Kybernetika-SPSE/RP_Svitek/README.md

# RP_Svitek
Model malého letadla na dálkové ovládání se zaměřením na aerodynamiku.
