Kybernetika-SPSE/RP_Svitek/součástky/list.md

# **Seznam součástek**
seznam součástek potřebných k provozu
## ovladač
- HC-12
- ESP32
- Joysticky ze starého ovladače
## letadlo
- ESP32
- HC-12
- **[lepší letadlový motor](https://www.houska-modelar.cz/shop/product_info.php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)**
- [Serva](https://www.laskakit.cz/mini-servo-mg90s-s-kovovymi-prevody/)
- napájení
  -  **[baterie 1](https://www.rcprofi.cz/kavan-li-po-1300mah-11-1v-40-80c-14-4wh)** 
- [ESC ](https://www.bighobby.cz/regulator-otacek-40a-hornet--2-4s-/)
- [vrtule](https://www.rcprofi.cz/apc-vrtule-8x4-pravotociva)

## doplňky
- [LiPo nabioječka](https://www.laskakit.cz/imax-b3-20w-nabijecka-1-6a-pro-2s-3s-lipo-baterie/)
- [multimetr](https://www.laskakit.cz/aneng-dm850-digitalni-multimetr/)
