Kybernetika-SPSE/RP_Svitek/zapojení/zapojení LETADLO.md

## Zapojení letadla
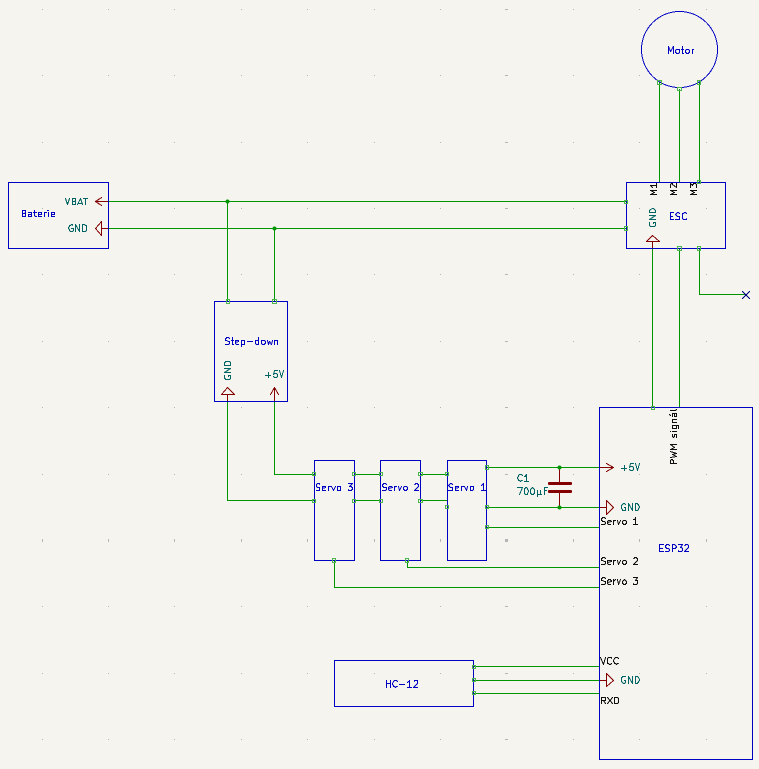
[picture p1: zapojení/jednoduché schéma.png]


Jednoduché zapojení elektroniky v letadle, [baterie](https://www.rcprofi.cz/kavan-li-po-1300mah-11-1v-40-80c-14-4wh) dodává zhruba 11V a maximálně až 106A do [ESC](https://www.bighobby.cz/regulator-otacek-40a-hornet--2-4s-/), který vytvoří trojfázový AC pro napájení [motoru](https://www.houska-modelar.cz/shop/product_info.php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) který bere okolo 20-25A což baterie dokáže poskytnout bez problémů. 

Kondenzátor slouží k potlačení napěťových špiček a stabilizaci 5V zdroje. Timto bude ESP napájeno stabilně a step-down zvládne zátěž až 5A což je víc než dost. Přes ESP pak budeme ovládat skrze ESC Throttle motoru.

Tenhle ESC má vlastní zdroj "BEC" který má limit 3A což bude stačit pro Serva + ESP. 3x Serva.
