Kybernetika-SPSE/RP_Svitek/součástky/Motor.md

# **Motor a vrtule**
## Motor 1
Po menším skenování online obchodů a diskuzi s Ai jsem si vybral motor **[MT2204](https://www.hadex.cz/l741-motor-stridavy-mt2204-pro-drony-pravotocivy/?gad_source=1&gad_campaignid=17347780553)**, který **váží pouze 25g** a jeho maximální tah se správnou vrtulí a baterií je 440g což snad mude stačit pro můj model u kterého čekám hmotnost tak 150-200g. Tah by měl být alespoň 2x váha aby letadlo mohlo vzlétnout. Pokud model bude těžší tak hodu dát na každé křídlo jeden motor jako u komerčních cestovních letadel. Motor bude potřenovat napětí alespoň 7,4V a ideálně okolo **11V a 5,5A**.

## Motor 2
jelikož motor 1 je určen pro drony tak má více otáček což znamená že je účinější s menšími vrtulemi, dalíš mototr co sem vybral je [KAVAN Brushless motor C2822-1400](https://www.houska-modelar.cz/shop/product_info.php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), je to přímo motor pro RC letadla takže má větší tah při nižších otáčkách a je tišší. Tohle je asi **lepší volba**.

## Vrtule
V technické specifikaci je doporučená pro motor [MT2204](https://www.hadex.cz/l741-motor-stridavy-mt2204-pro-drony-pravotocivy/?gad_source=1&gad_campaignid=17347780553) vrtule velikosti 5"-6". Takových vrtulí je všude na internetu dost jedno balení co se mi líbilo je **[6x4E Bi Blade Propeller Pack of 5](https://www.unmannedtechshop.co.uk/products/6x4e-bi-blade-propeller-pack-of-5-hee-wing-f-01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)** tohle je dost levné a snad 5 vrtulí bude stačit.

pro mototr **KAVAN Brushless motor C2822-1400** jsou vrtule větší takže něco jako tato [vrtule](https://www.rcprofi.cz/apc-vrtule-8x6-pravotociva#description)
