Kybernetika-SPSE/RP_Svitek/dokumentace/Cm graf.png

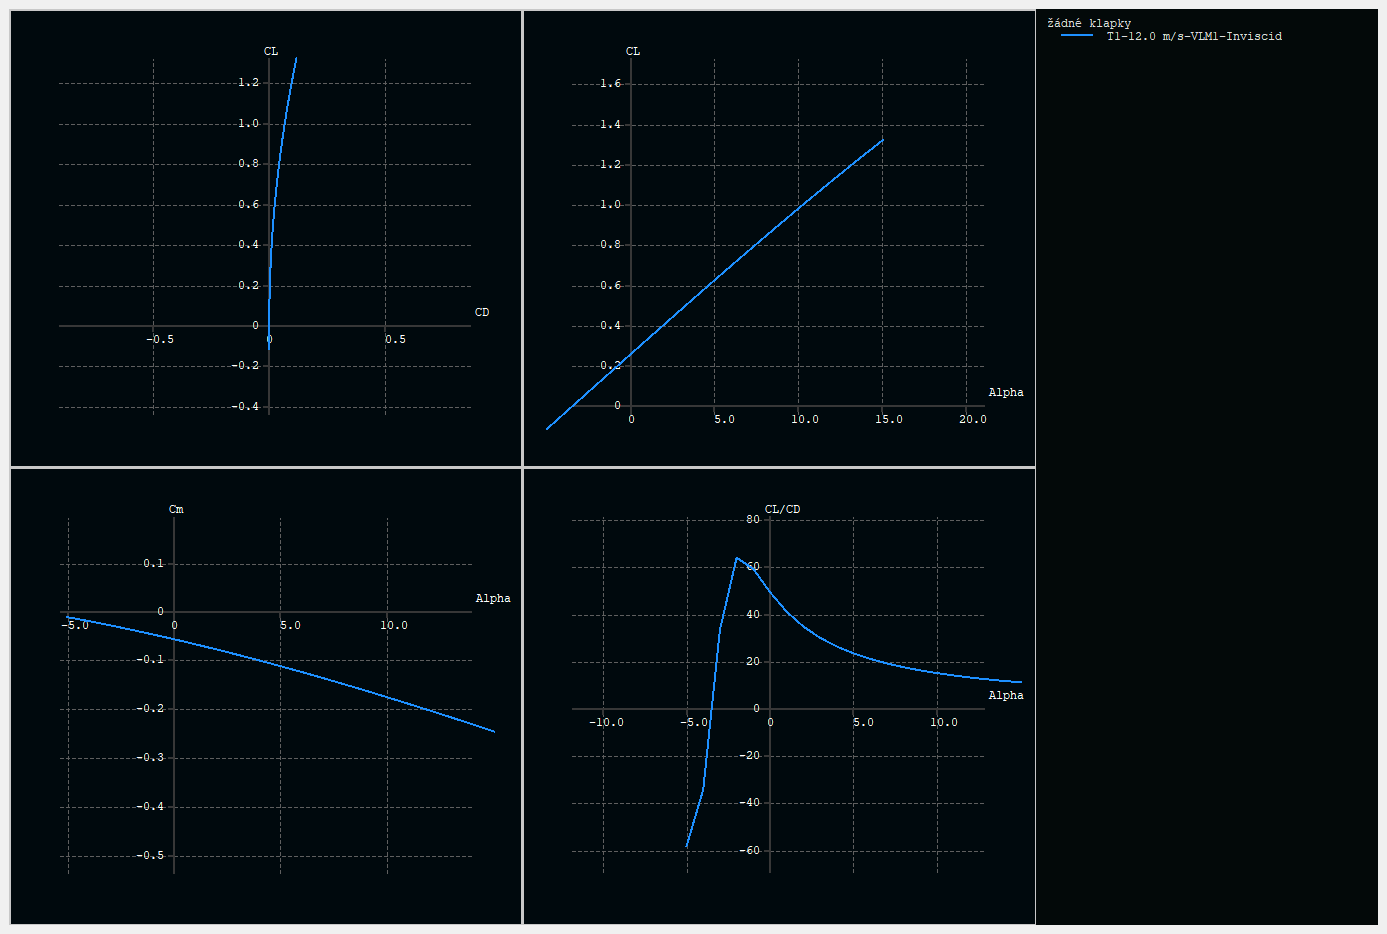
dokumentace/Cm graf.png
