Kybernetika-SPSE/RP_Svitek/dokumentace/IMG_2235.jpg

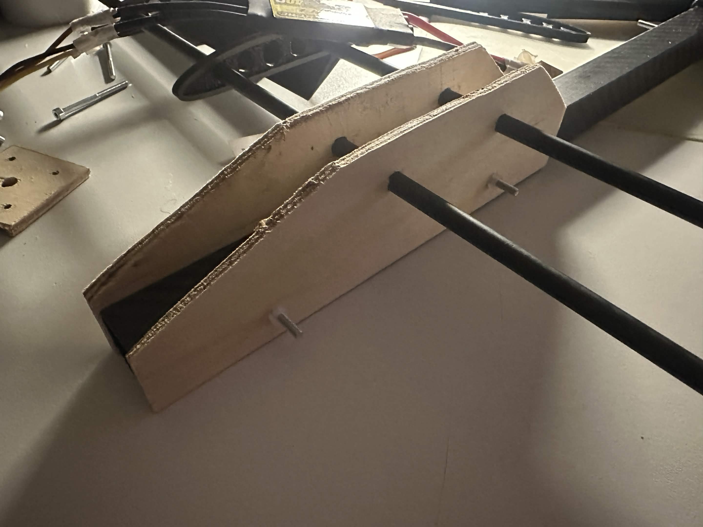
dokumentace/IMG_2235.jpg
