Kybernetika-SPSE/RP_Svitek/dokumentace/rozlozeni_tlaku.png

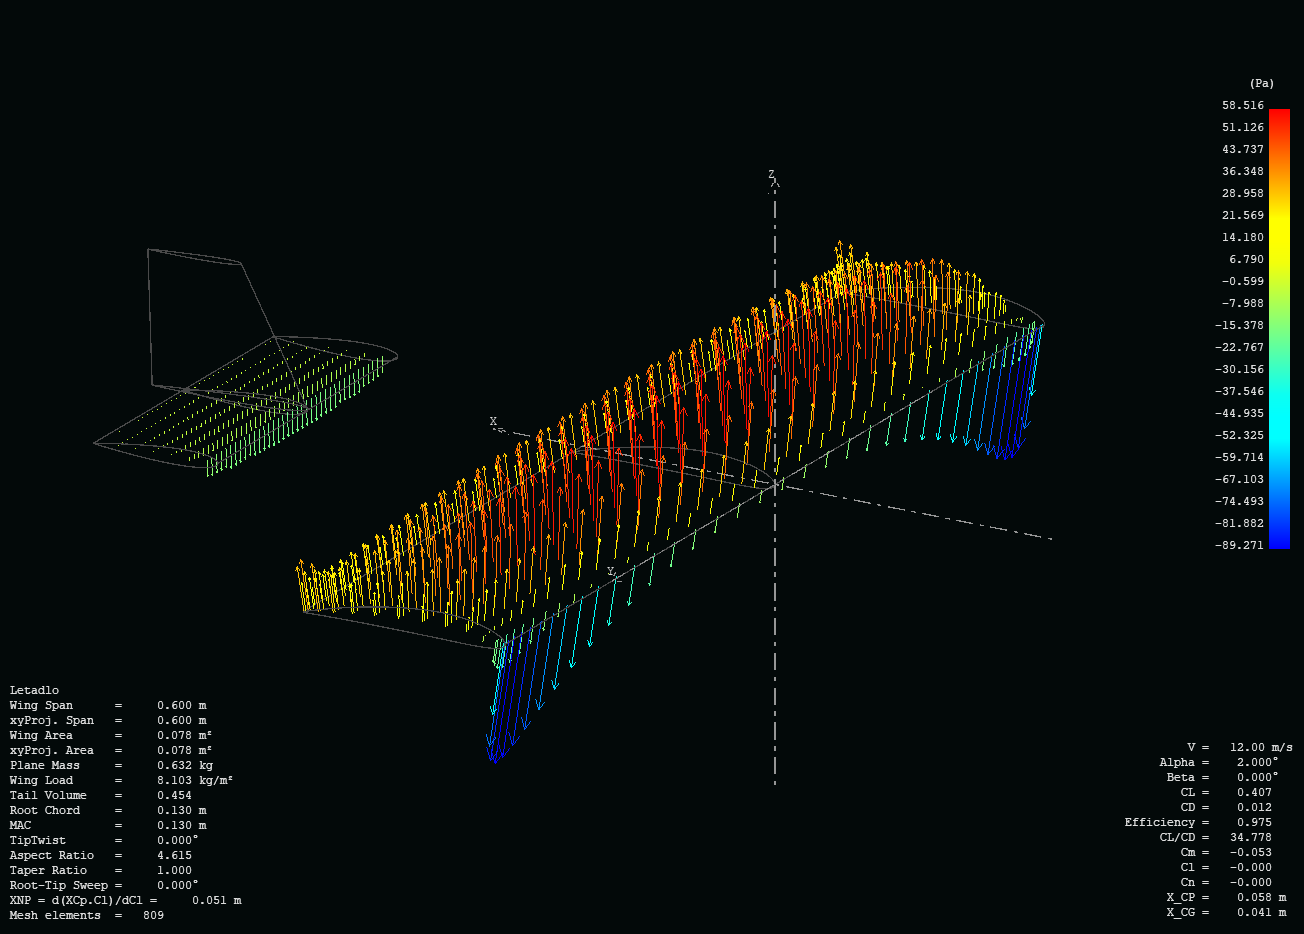
dokumentace/rozlozeni_tlaku.png
