Kybernetika-SPSE/RP_Svitek/(list of files, cad)

Other CAD files:
3d model/výkresy/SERVO držák.dwg
3d model/výkresy/vertical_stab.dwg
3d model/výkresy/Aileronn.dwg
3d model/výkresy/horizontal_stab.dwg
3d model/výkresy/Profil NACA 4412.dwg
3d model/výkresy/horizontal_stab_elevator.dwg
3d model/výkresy/OldVersions/SERVO držák.0009.dwg
3d model/výkresy/OldVersions/vertical_stab.0007.dwg
3d model/výkresy/OldVersions/horizontal_stab.0004.dwg
3d model/výkresy/OldVersions/Aileronn.0001.dwg
3d model/výkresy/OldVersions/Profil NACA 4412.0009.dwg
3d model/OldVersions/Profil NACA 4412 2.0011.ipt
3d model/OldVersions/Profil NACA 4412 NOFLAPS.0001.ipt
3d model/OldVersions/Profil NACA 4412.0008.ipt
3d model/OldVersions/Sestava1.0005.iam
3d model/OldVersions/pokus 1 .0004.ipt
3d model/OldVersions/pokus 1 flap 4412 .0004.ipt
3d model/Profil NACA 4412 NOFLAPS.ipt
3d model/Profil NACA 4412.ipt
3d model/Sestava1.iam
3d model/lepší/AS 1110 - M5 x 25.ipt
3d model/lepší/Aileronn.ipt
3d model/lepší/Hlavni_pater.ipt
3d model/lepší/NOAileron.ipt
3d model/lepší/NOAileronSERVO.ipt
3d model/lepší/OldVersions/Aileronn.0006.ipt
3d model/lepší/OldVersions/Hlavni_pater.0009.ipt
3d model/lepší/OldVersions/NOAileron.0005.ipt
3d model/lepší/OldVersions/NOAileronSERVO.0001.ipt
3d model/lepší/OldVersions/NOailer.0001.ipt
3d model/lepší/OldVersions/Profil NACA 0012.0004.ipt
3d model/lepší/OldVersions/Profil NACA 4412 2.0013.ipt
3d model/lepší/OldVersions/Profil.0006.ipt
3d model/lepší/OldVersions/SERVO držák.0011.ipt
3d model/lepší/OldVersions/Servo.0005.ipt
3d model/lepší/OldVersions/Sestava.0079.iam
3d model/lepší/OldVersions/Sestava_mark1.0002.iam
3d model/lepší/OldVersions/Trup.0006.ipt
3d model/lepší/OldVersions/horizontal_stab.0021.ipt
3d model/lepší/OldVersions/horizontal_stab_elevator.0008.ipt
3d model/lepší/OldVersions/motor držák.0001.ipt
3d model/lepší/OldVersions/trojúhleník.0015.ipt
3d model/lepší/OldVersions/trojúhleník_FF.0002.ipt
3d model/lepší/OldVersions/trojúhleník_closer.0003.ipt
3d model/lepší/OldVersions/táhlo.0001.ipt
3d model/lepší/OldVersions/tělo_pokus2.0006.ipt
3d model/lepší/OldVersions/vertical_stab.0012.ipt
3d model/lepší/OldVersions/vetrovaniig.0004.ipt
3d model/lepší/Profil NACA 0012.ipt
3d model/lepší/Profil NACA 4412 2.ipt
3d model/lepší/Profil.ipt
3d model/lepší/SERVO držák.ipt
3d model/lepší/Servo.ipt
3d model/lepší/Sestava.iam
3d model/lepší/Sestava_mark1.iam
3d model/lepší/Sestava_mark2.iam
3d model/lepší/Trup.ipt
3d model/lepší/Těl_tyč.ipt
3d model/lepší/drzakmotoru_nový.ipt
3d model/lepší/horizontal_stab.ipt
3d model/lepší/horizontal_stab_elevator.ipt
3d model/lepší/motor držák.ipt
3d model/lepší/trojúhleník.ipt
3d model/lepší/trojúhleník_FF.ipt
3d model/lepší/tyč.ipt
3d model/lepší/táhlo.ipt
3d model/lepší/tělo_pokus2.ipt
3d model/lepší/vertical_stab.ipt
3d model/lepší/vetrovaniig.ipt
3d model/pokus 1 .ipt
3d model/pokus 1 flap 4412 .ipt
3d model/tyč.ipt
3d model/výkresy/Hlavni_pater.idw
3d model/výkresy/OldVersions/Hlavni_pater.0004.idw
3d model/výkresy/OldVersions/Trup.0006.idw
3d model/výkresy/Trup.idw
3d model/výkresy/Uchytka_motoru.idw
