Kybernetika-SPSE/RP_Svitek/Software/TESTY/HC-12 RXTX test/test_LEDky_a _joystick_HC-12/přijímač.jpg

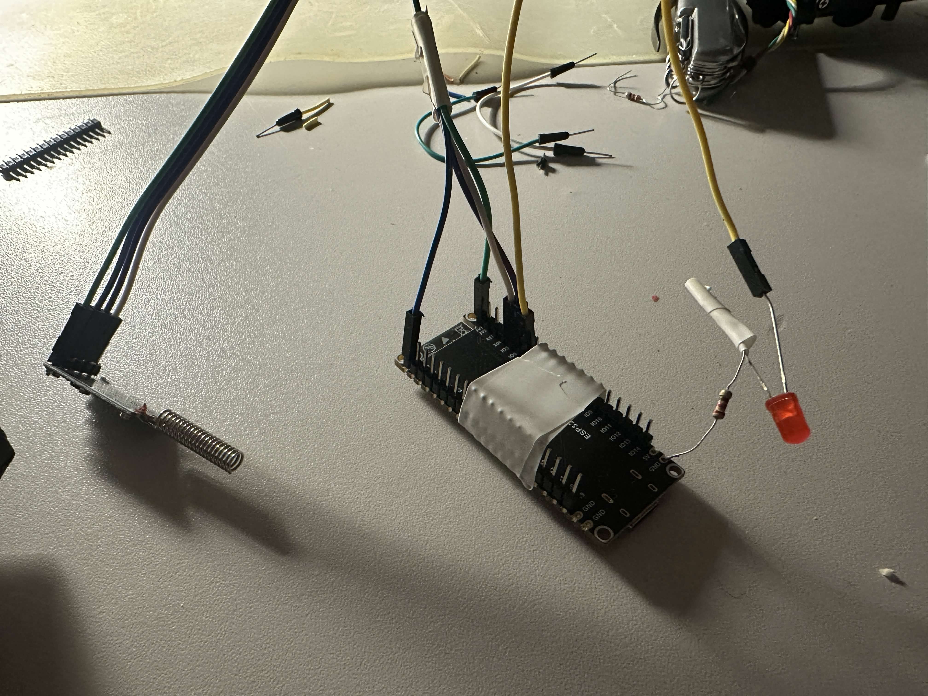
Software/TESTY/HC-12 RXTX test/test_LEDky_a _joystick_HC-12/přijímač.jpg
