Kybernetika-SPSE/RP_Svitek/XFLR/TEST/sim a = 5°/ailerons DOWN.png

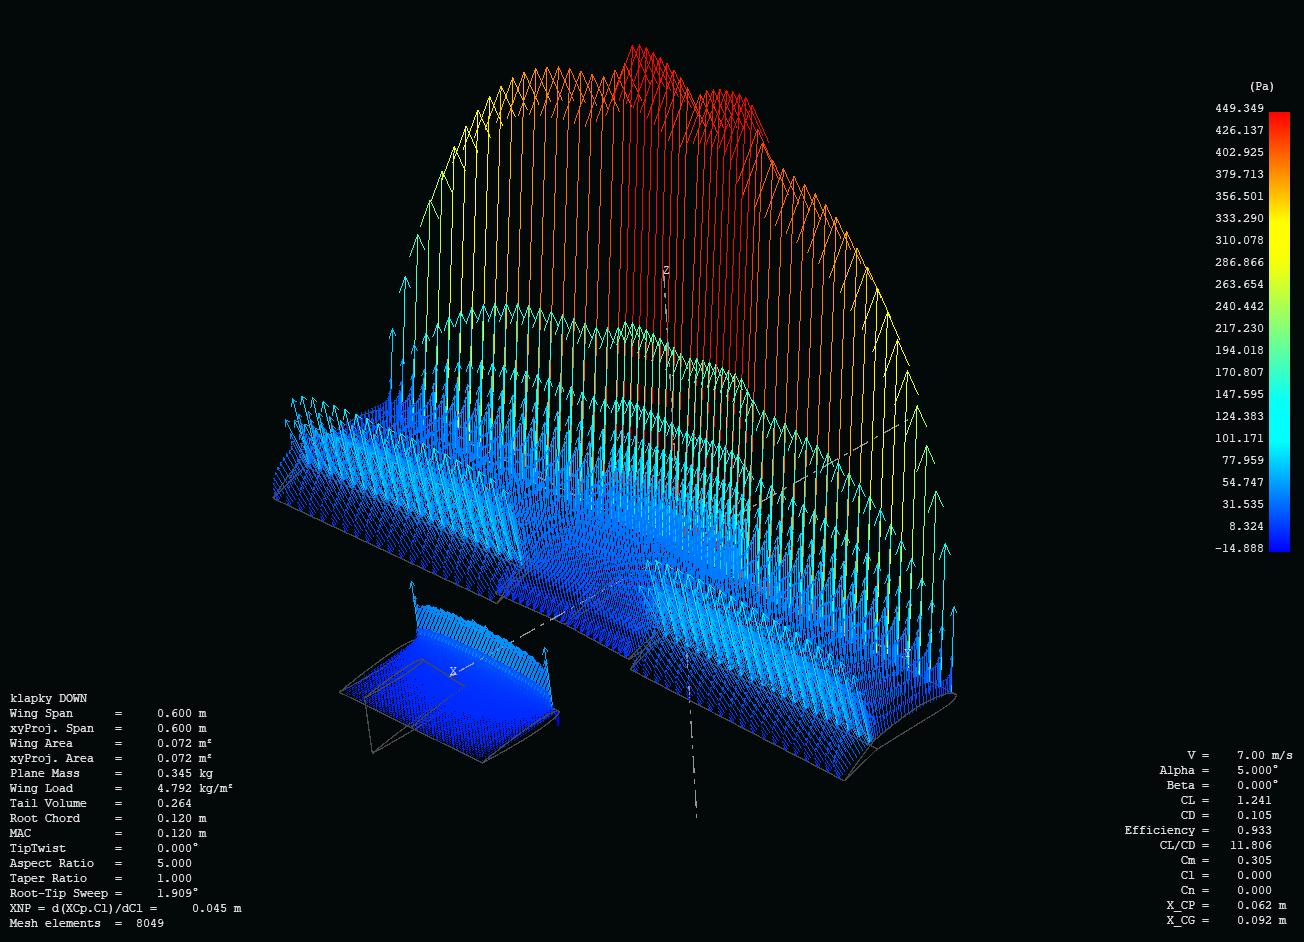
XFLR/TEST/sim a = 5°/ailerons DOWN.png
