Kybernetika-SPSE/RP_Svitek/XFLR/TEST/sim a = 5°/ailerons UP.png

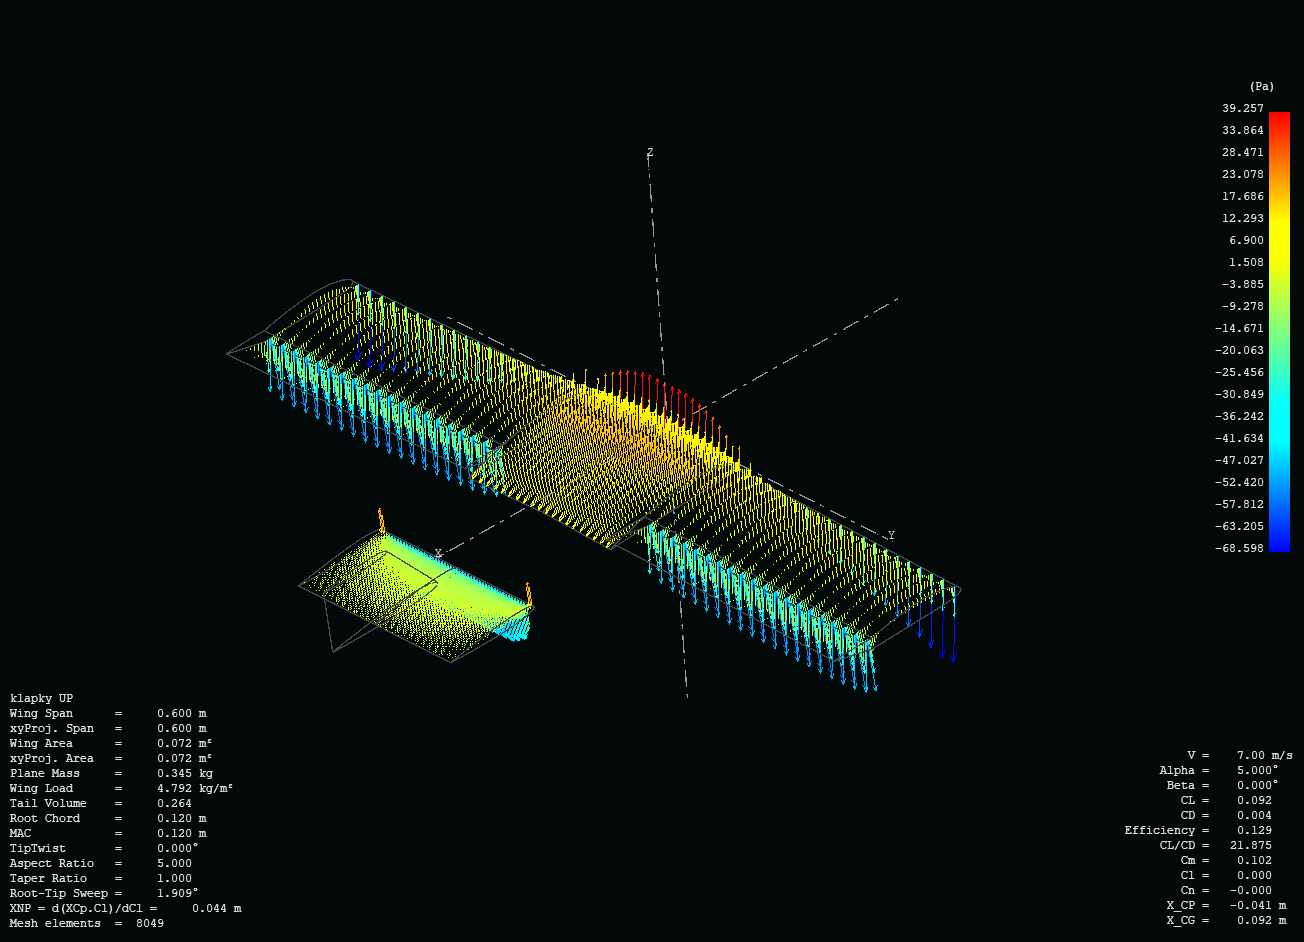
XFLR/TEST/sim a = 5°/ailerons UP.png
