Kybernetika-SPSE/RP_Svitek/XFLR/TEST/sim a = 5°/CL graf profil 4412.png

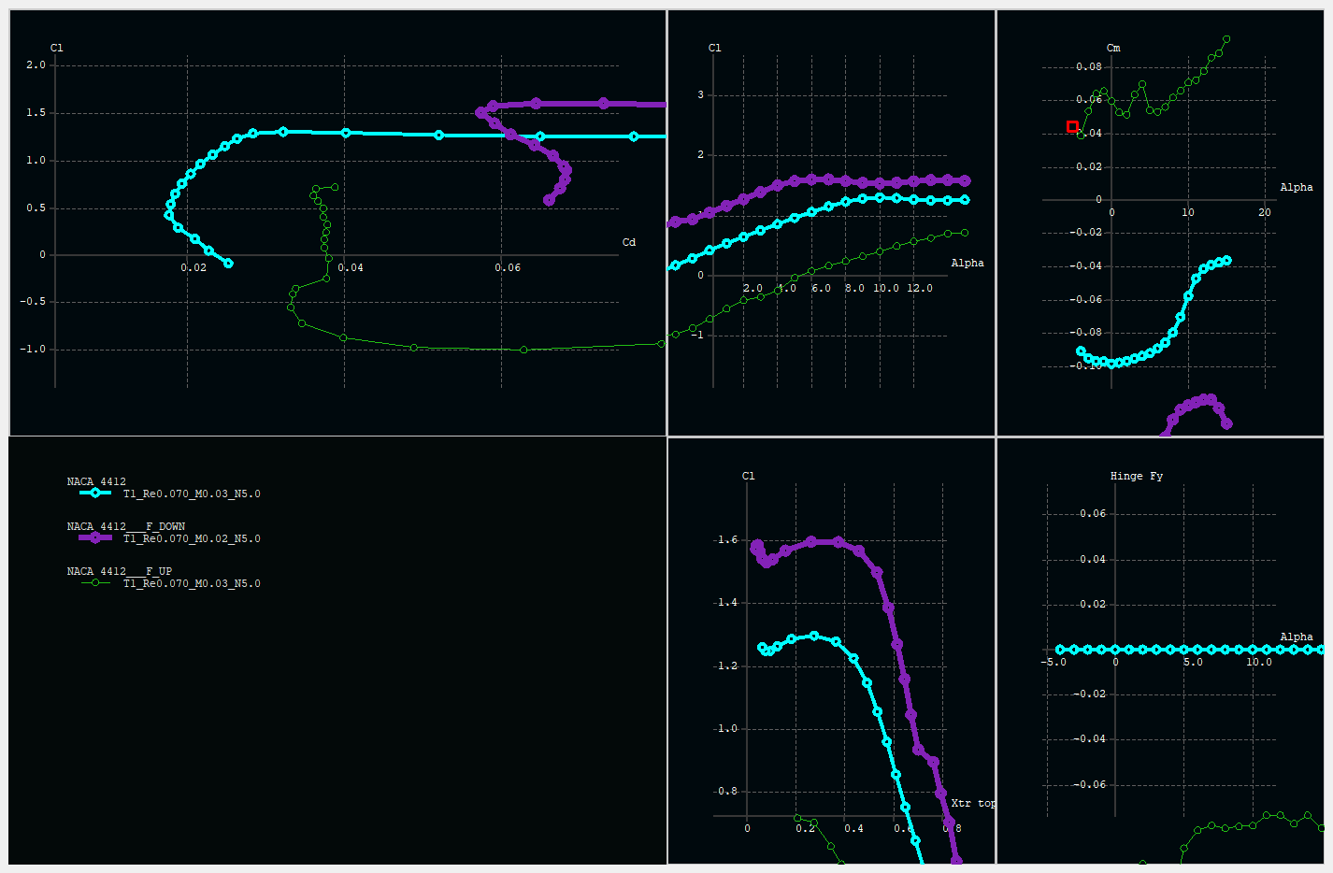
XFLR/TEST/sim a = 5°/CL graf profil 4412.png
