Kybernetika-SPSE/RP_Svitek/XFLR/TEST/sim a = 5°/CL graf.png

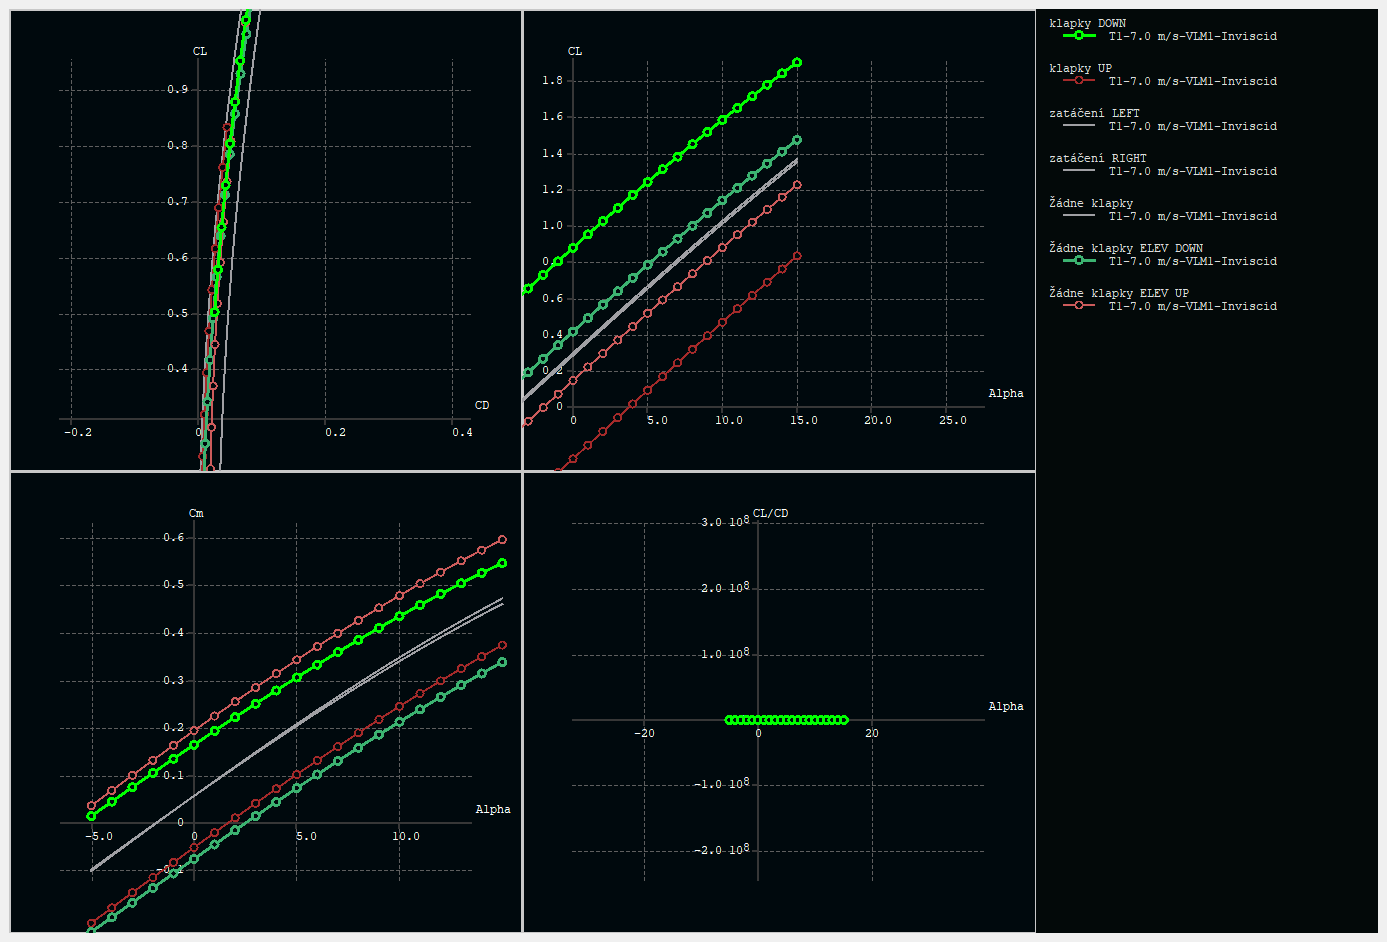
XFLR/TEST/sim a = 5°/CL graf.png
