Kybernetika-SPSE/RP_Svitek/XFLR/TEST/sim a = 5°/rozložení tíhy.png

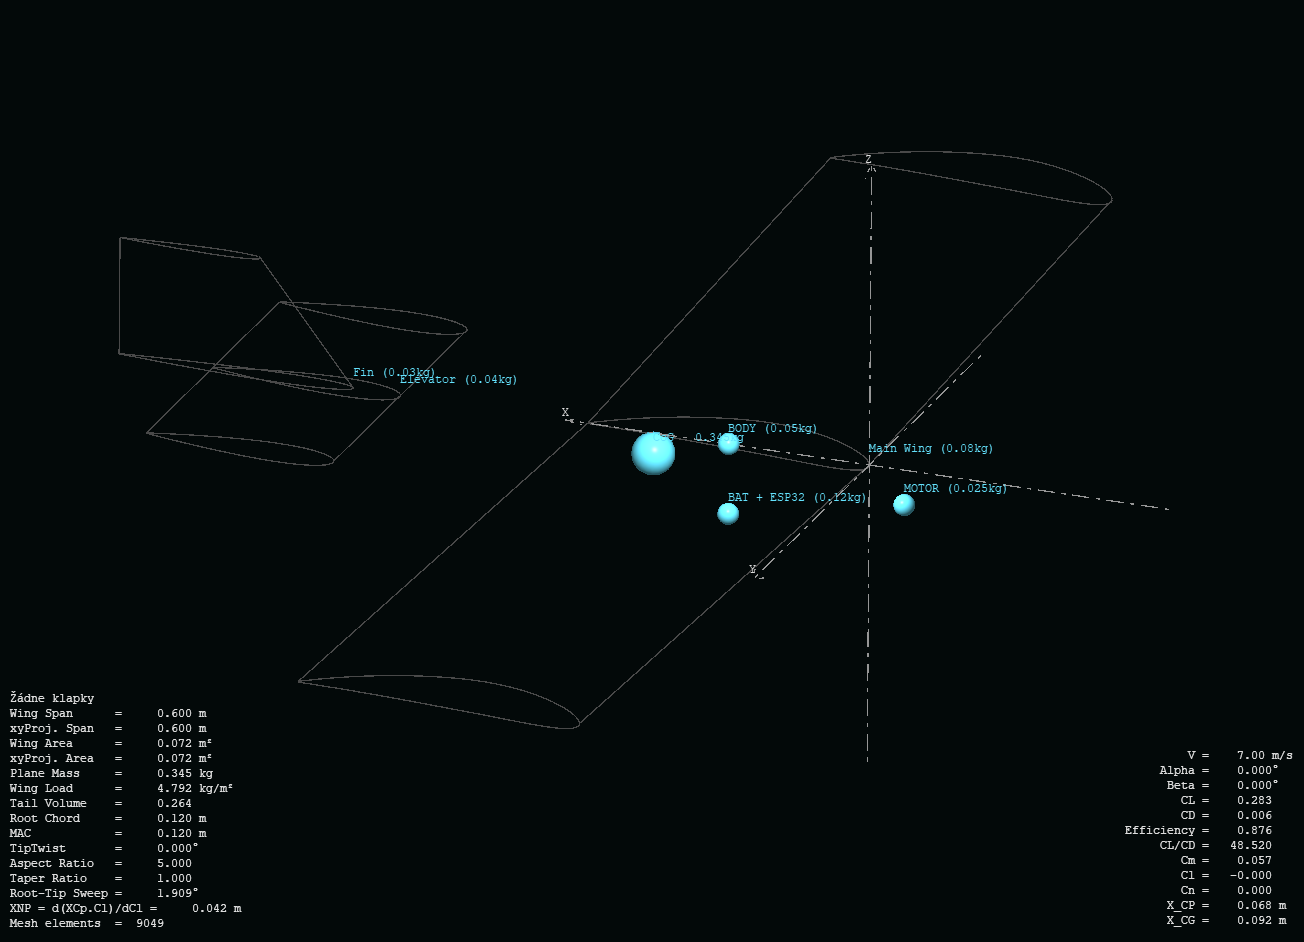
XFLR/TEST/sim a = 5°/rozložení tíhy.png
