Kybernetika-SPSE/RP_Svitek/XFLR/TEST/sim a = 5°/zatáčení LEFT.png

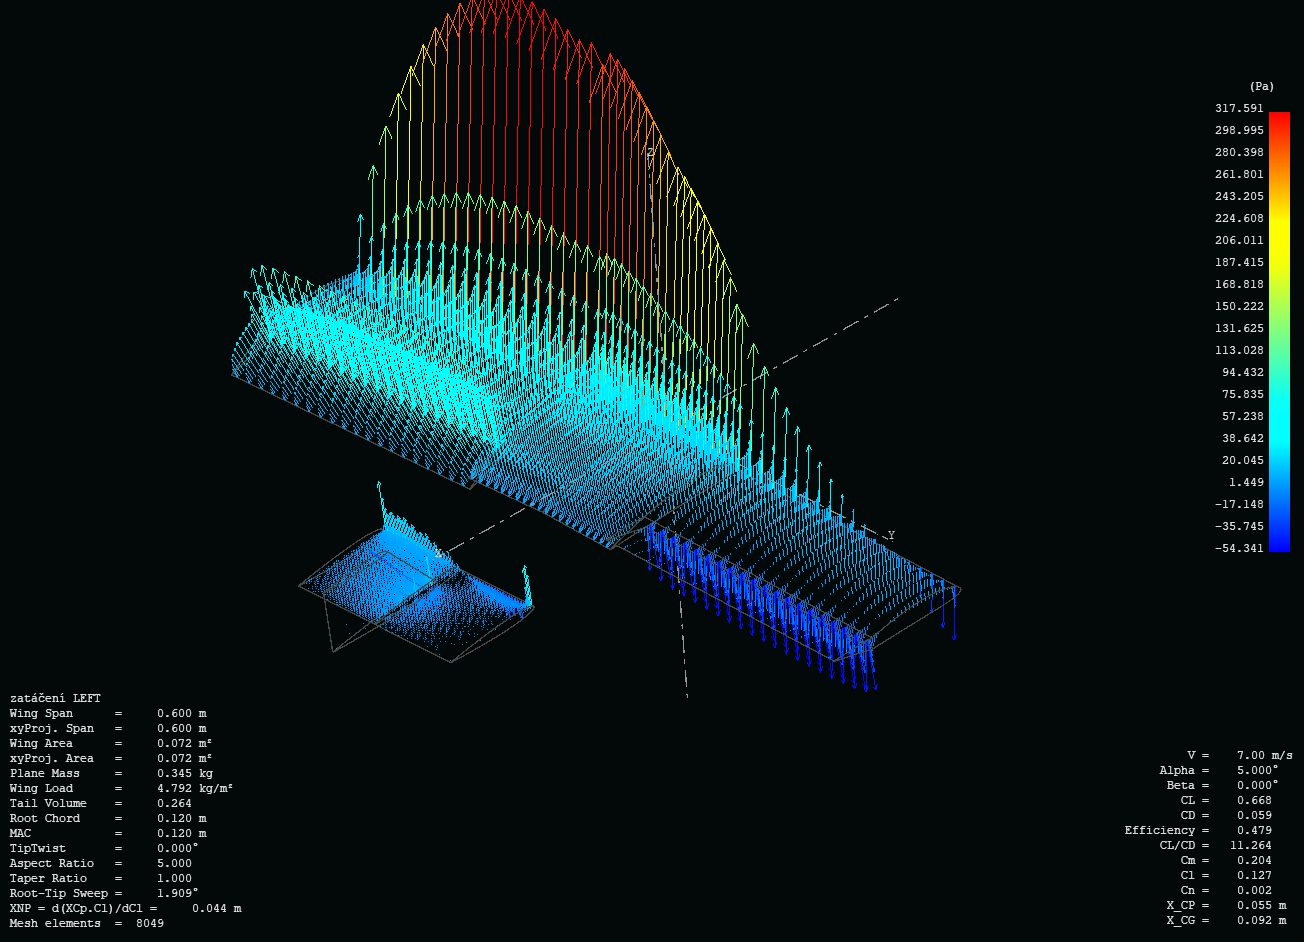
XFLR/TEST/sim a = 5°/zatáčení LEFT.png
