Kybernetika-SPSE/RP_Svitek/XFLR/TEST/sim a = 5°/zatáčení RIGHT.png

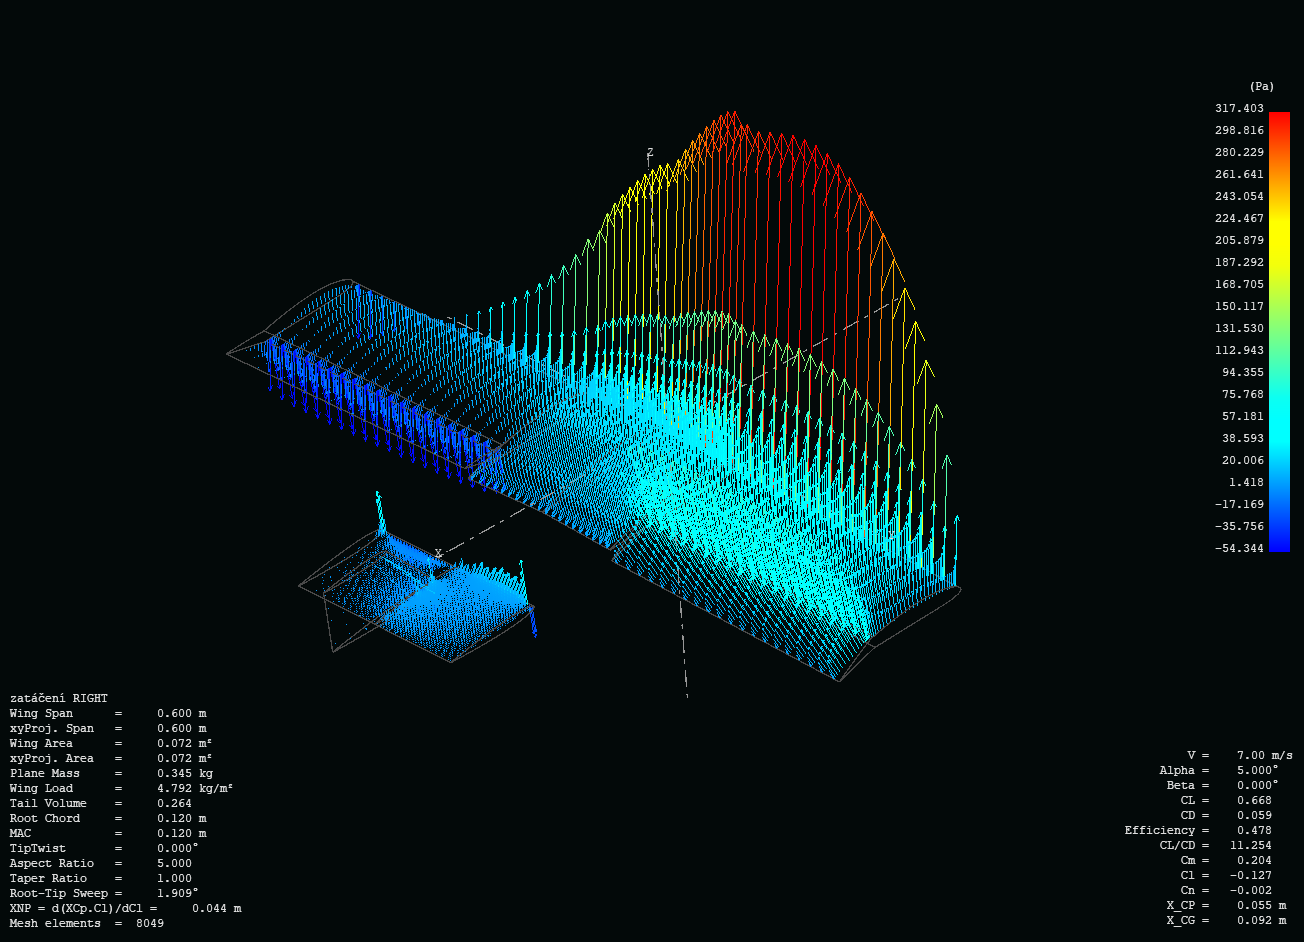
XFLR/TEST/sim a = 5°/zatáčení RIGHT.png
