Kybernetika-SPSE/RP_Svitek/XFLR/TEST/sim a = 5°/Žádné klapky ELEV DOWN.png

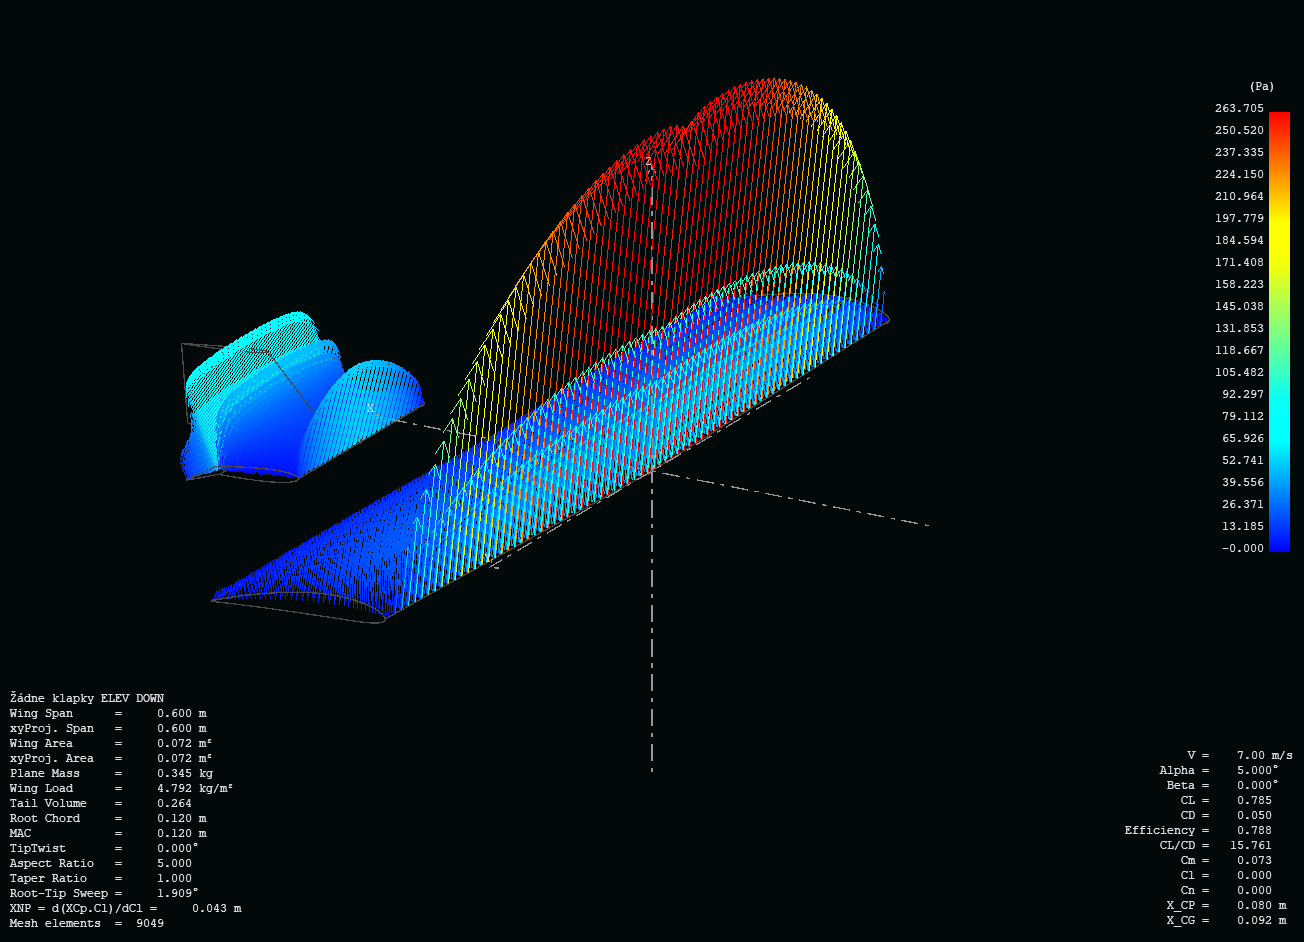
XFLR/TEST/sim a = 5°/Žádné klapky ELEV DOWN.png
