Kybernetika-SPSE/RP_Svitek/XFLR/TEST/sim a = 5°/Žádné klapky ELEV UP.png

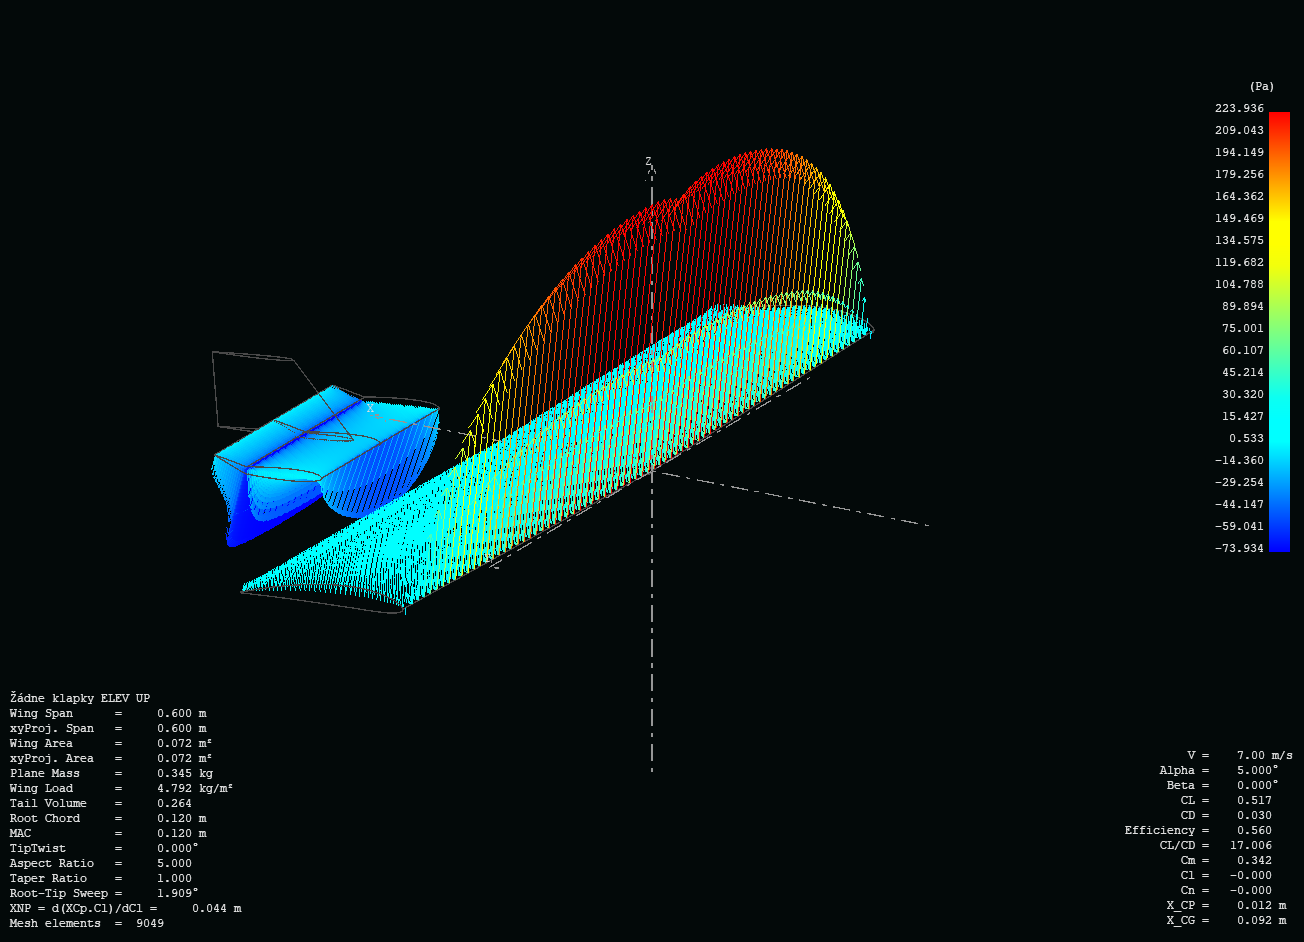
XFLR/TEST/sim a = 5°/Žádné klapky ELEV UP.png
