Kybernetika-SPSE/RP_Svitek/3d model/výkresy/Dřevěná příložka.pdf

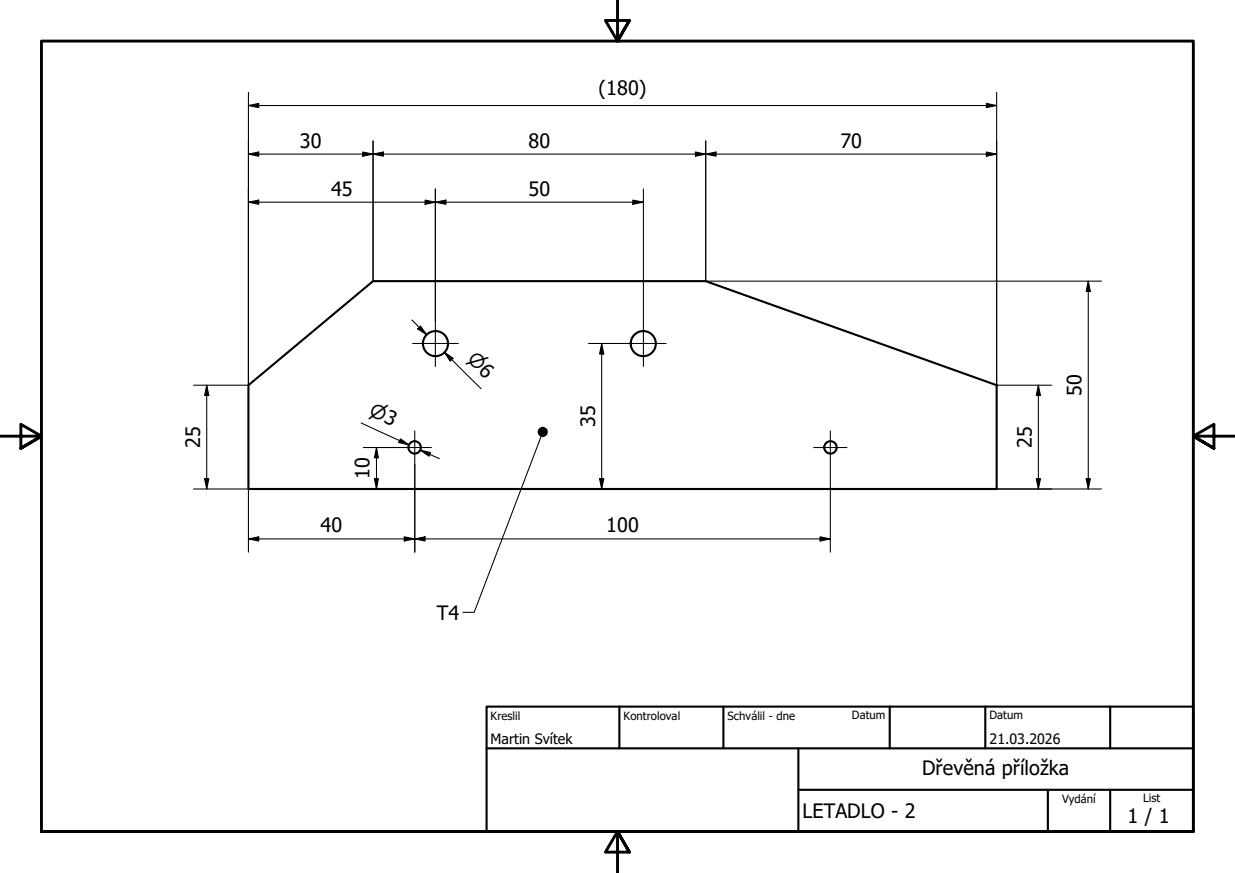
[picture p32: page 1]

Kreslil Martin Svítek | Kontroloval | Schválil - dne Datum | Datum 21.03.2026

Dřevěná příložka

LETADLO - 2 | Vydání | List 1 / 1
