Kybernetika-SPSE/RP_Svitek/(commit log)

2025-12-04 motory a vrtle + fixs
2025-12-05 změny provedené v dokumentaci motorů.
2026-01-05 fix
    Updated the table to include area values for each wing component and added a section on tail volume coefficient.
2026-01-05 hc-12 update
    Replaced 'ESP32 heltec V4' with 'HC-12' in the components list.
2026-01-17 lepší seznam součástek
    [Sestava1.0003.iam, Sestava1.iam, pokus 1 .0002.ipt, pokus 1 .0004.ipt, pokus 1 .ipt, pokus 1 flap 4412 .0004.ipt, pokus 1 flap 4412 .ipt, tyč.ipt]
2026-01-17 Fix typos
    Corrected typos and improved clarity in motor descriptions.
2026-01-17 +zapojení, 3D profil
    [Profil NACA 4412 NOFLAPS.ipt, Profil NACA 4412.0002.ipt, Profil NACA 4412.ipt, Sestava1.0003.iam, Sestava1.0005.iam, Sestava1.iam]
2026-02-11 HC-12 test s páčkou a LED
2026-02-25 lepší_3D_1
    [Aileronn.0004.ipt, Aileronn.ipt, NOAileron.0004.ipt, NOAileron.ipt, NOAileronSERVO.ipt, NOailer.0001.ipt, Profil NACA 0012.ipt, Profil NACA 4412 2.ipt]
2026-02-25 lepší_3D_2
    [NOAileronSERVO.0001.ipt, Profil NACA 0012.0004.ipt, Profil NACA 4412 2.0011.ipt, Profil NACA 4412 2.0012.ipt, Profil NACA 4412.0003.dwg, Profil NACA 4412.dwg, Profil.0004.ipt, Servo.0002.ipt]
2026-04-04 +dokumentace, 3d modely, výkresy
    [Aileronn.0004.ipt, Aileronn.0006.ipt, Aileronn.ipt, Hlavni_pater.0003.idw, Hlavni_pater.0007.ipt, Hlavni_pater.0009.ipt, Hlavni_pater.idw, Hlavni_pater.ipt]
